ICRS/IC-Hack-Badge/Images/hacker-back-silkscreen.png

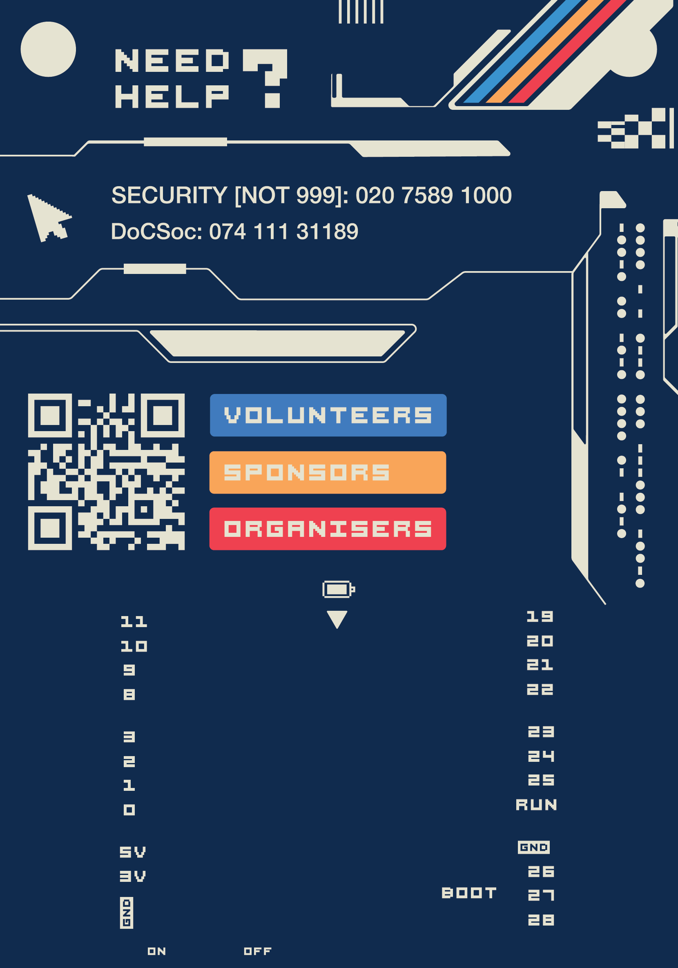
Images/hacker-back-silkscreen.png
