ICRS/IC-Hack-Badge/Images/hacker-back.png

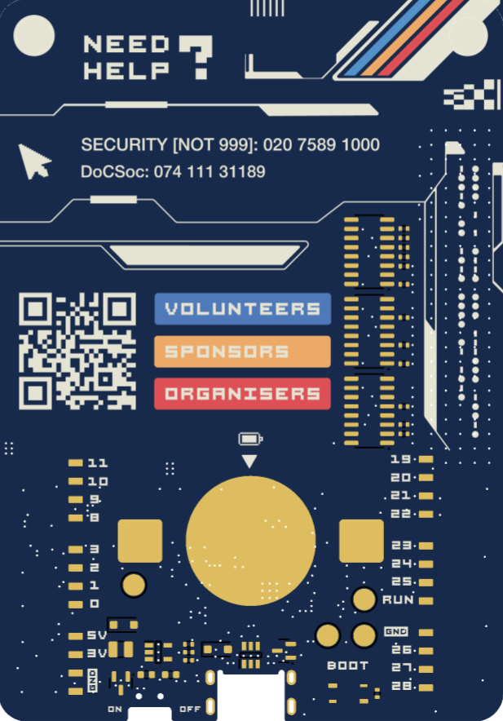
Images/hacker-back.png
