ICRS/IC-Hack-Badge/Images/hacker-front-silkscreen.png

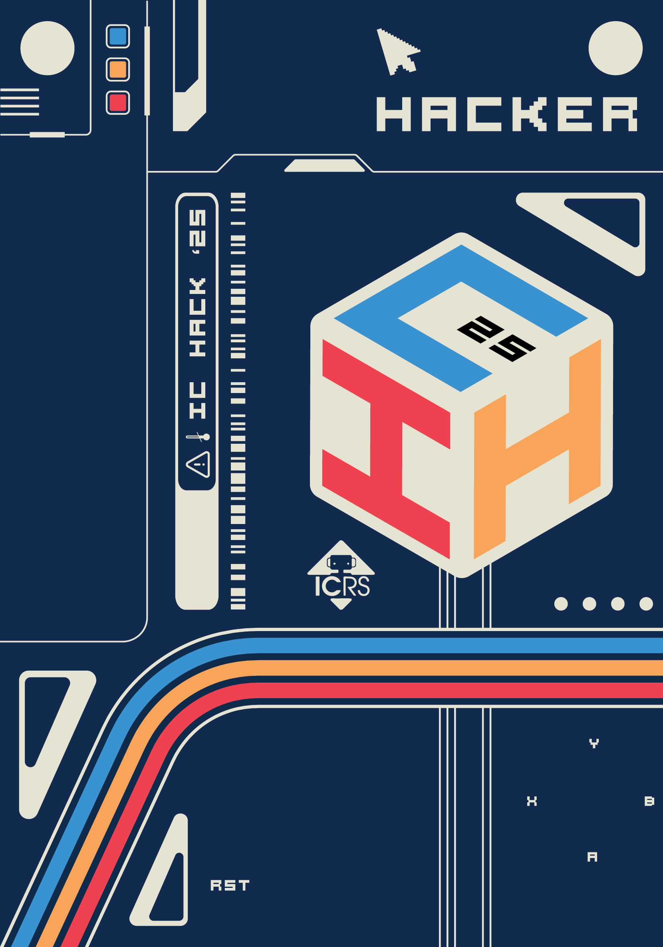
Images/hacker-front-silkscreen.png
