ICRS/IC-Hack-Badge/Images/pinout_whole.png

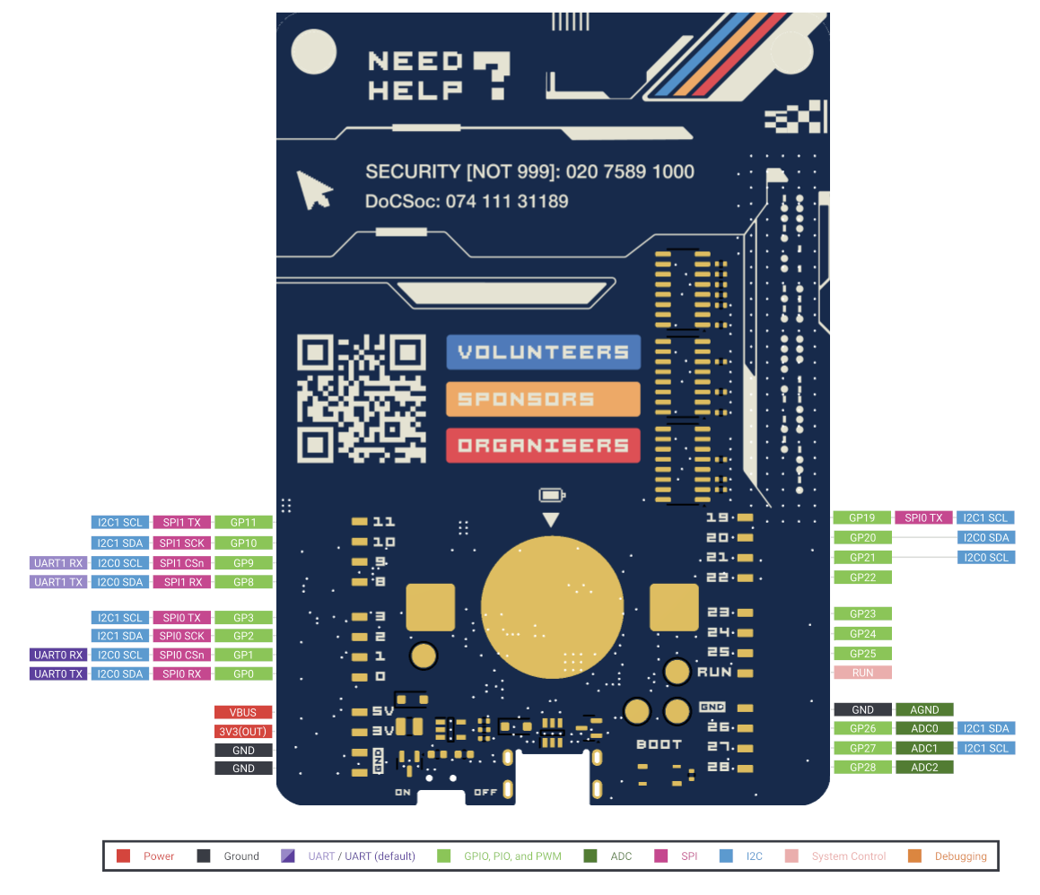
Images/pinout_whole.png
