ICRS/IC-Hack-Badge/Hardware/schematic.pdf

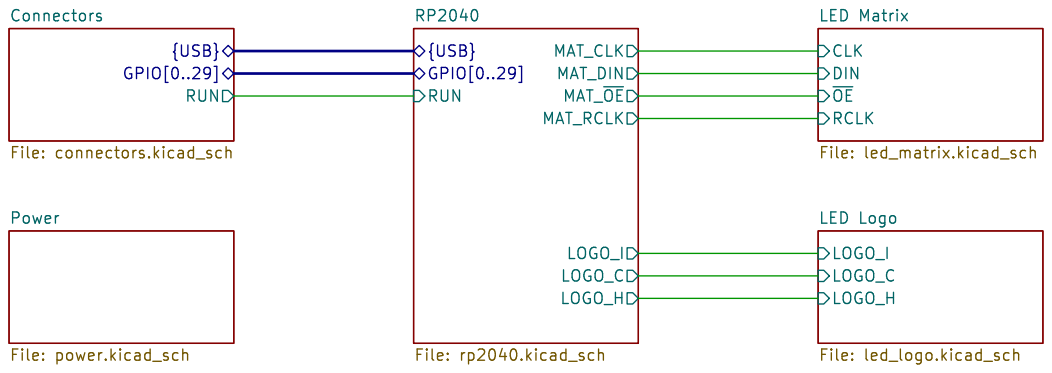
[picture p13: page 1]

{USB} RUN GPIO[0..29] Connectors File: connectors.kicad_sch

~{OE} LED Matrix File: led_matrix.kicad_sch

LED Logo File: led_logo.kicad_sch Power File: power.kicad_sch

Id: 1/6 Title: File: badge_v2.kicad_sch Sheet: /

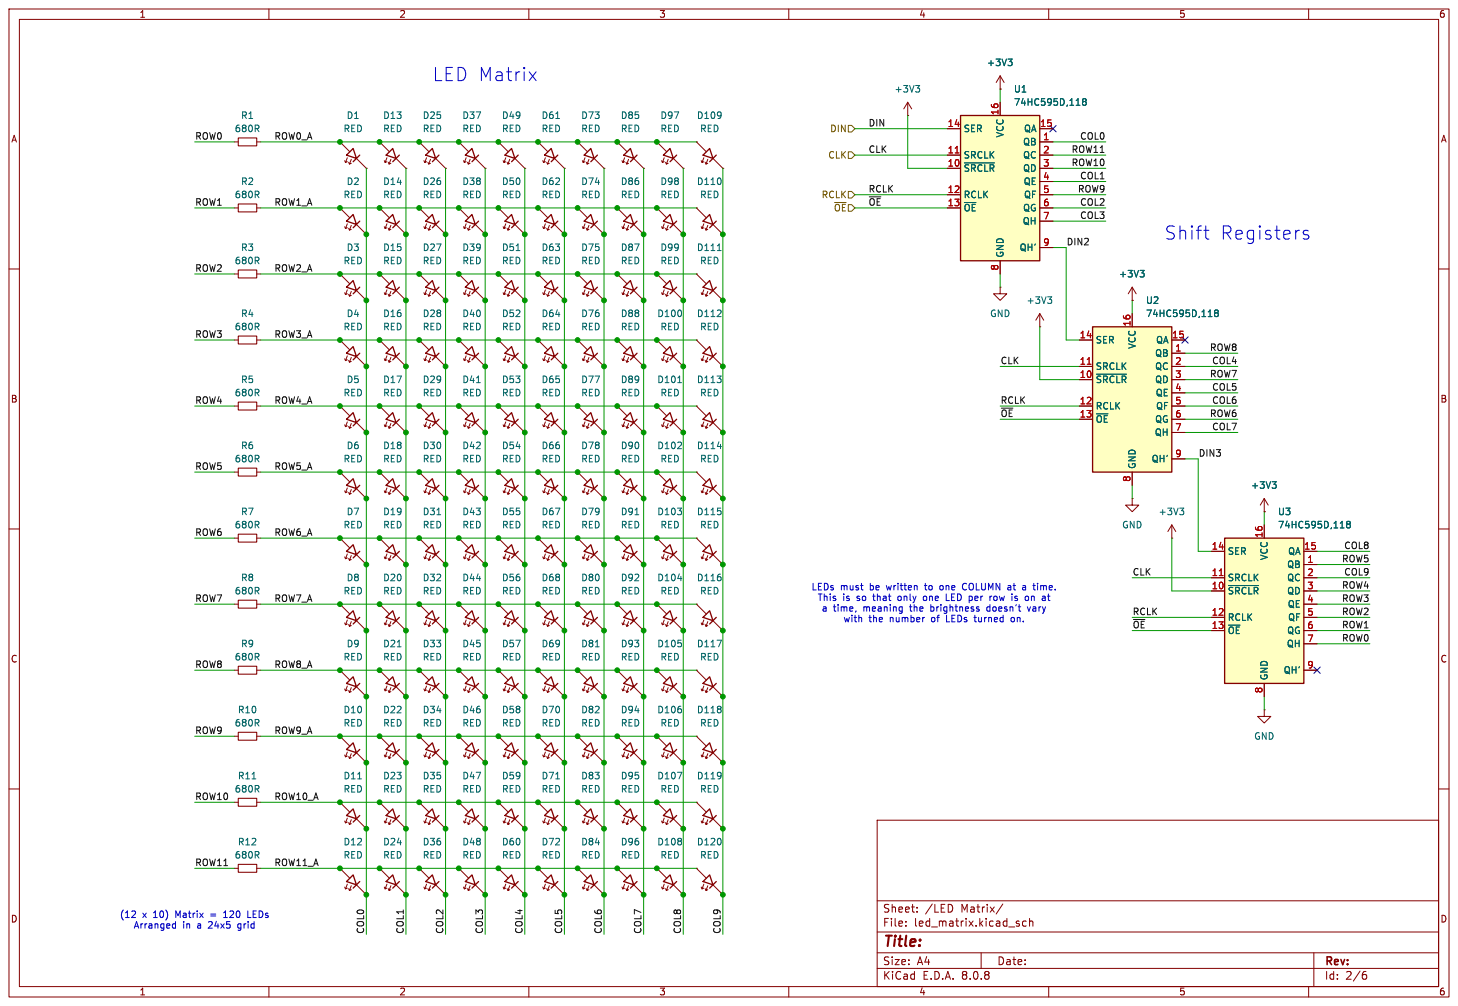
[picture p14: page 2]

(12 x 10) Matrix = 120 LEDs Arranged in a 24x5 grid

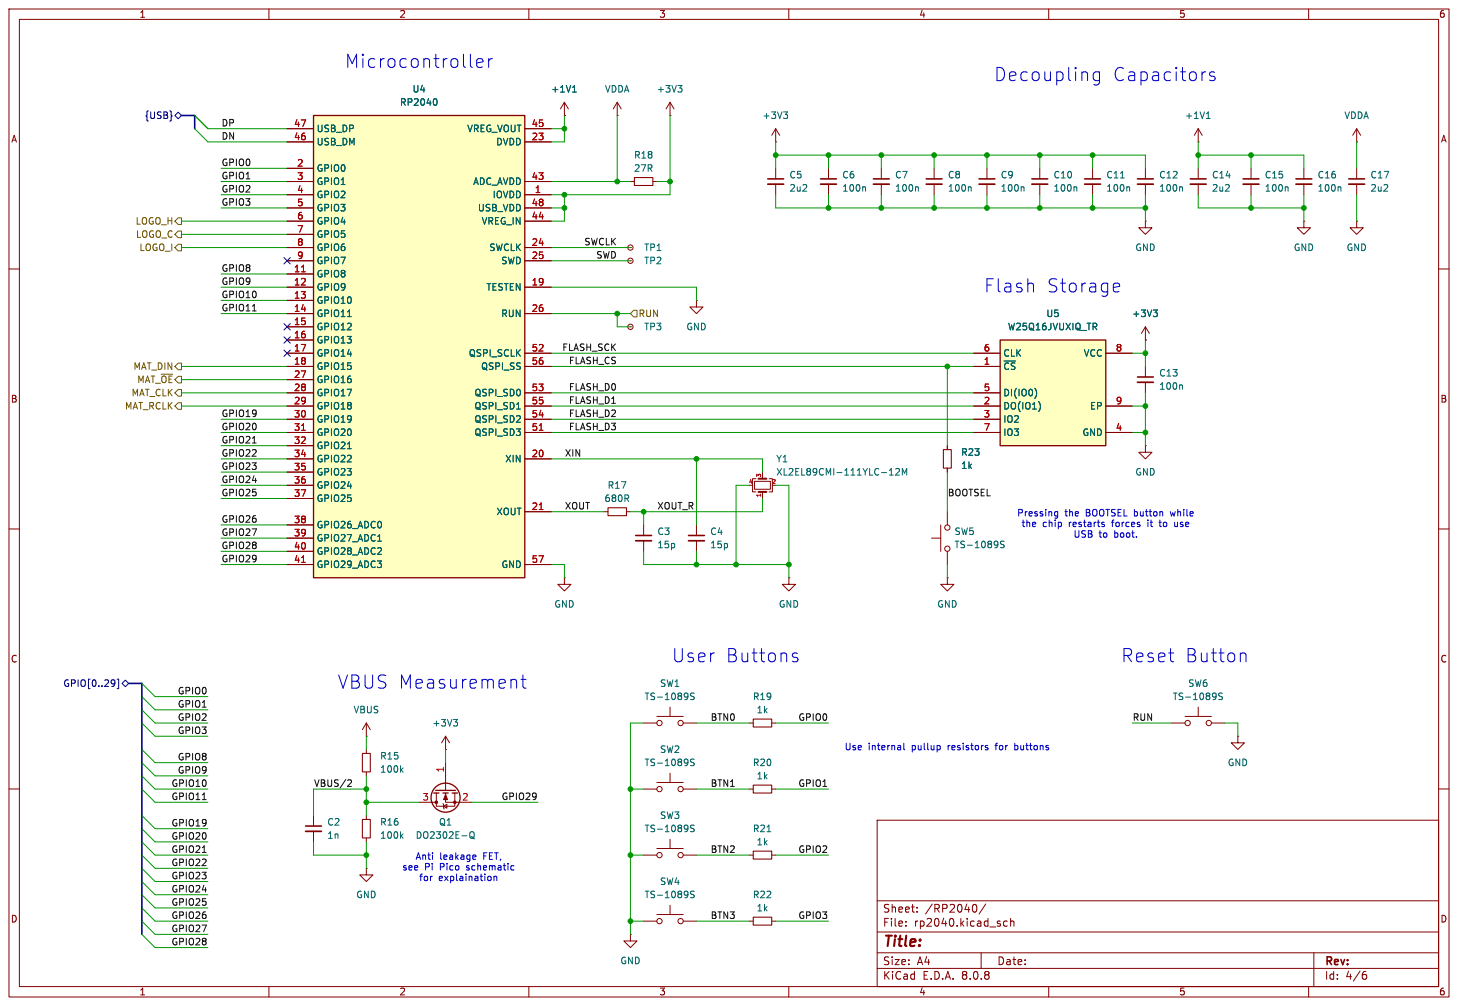
[picture p15: page 3]

Id: 4/6 Title: File: rp2040.kicad_sch Sheet: /RP2040/ R23

Pressing the BOOTSEL button while

Anti leakage FET, see Pi Pico schematic

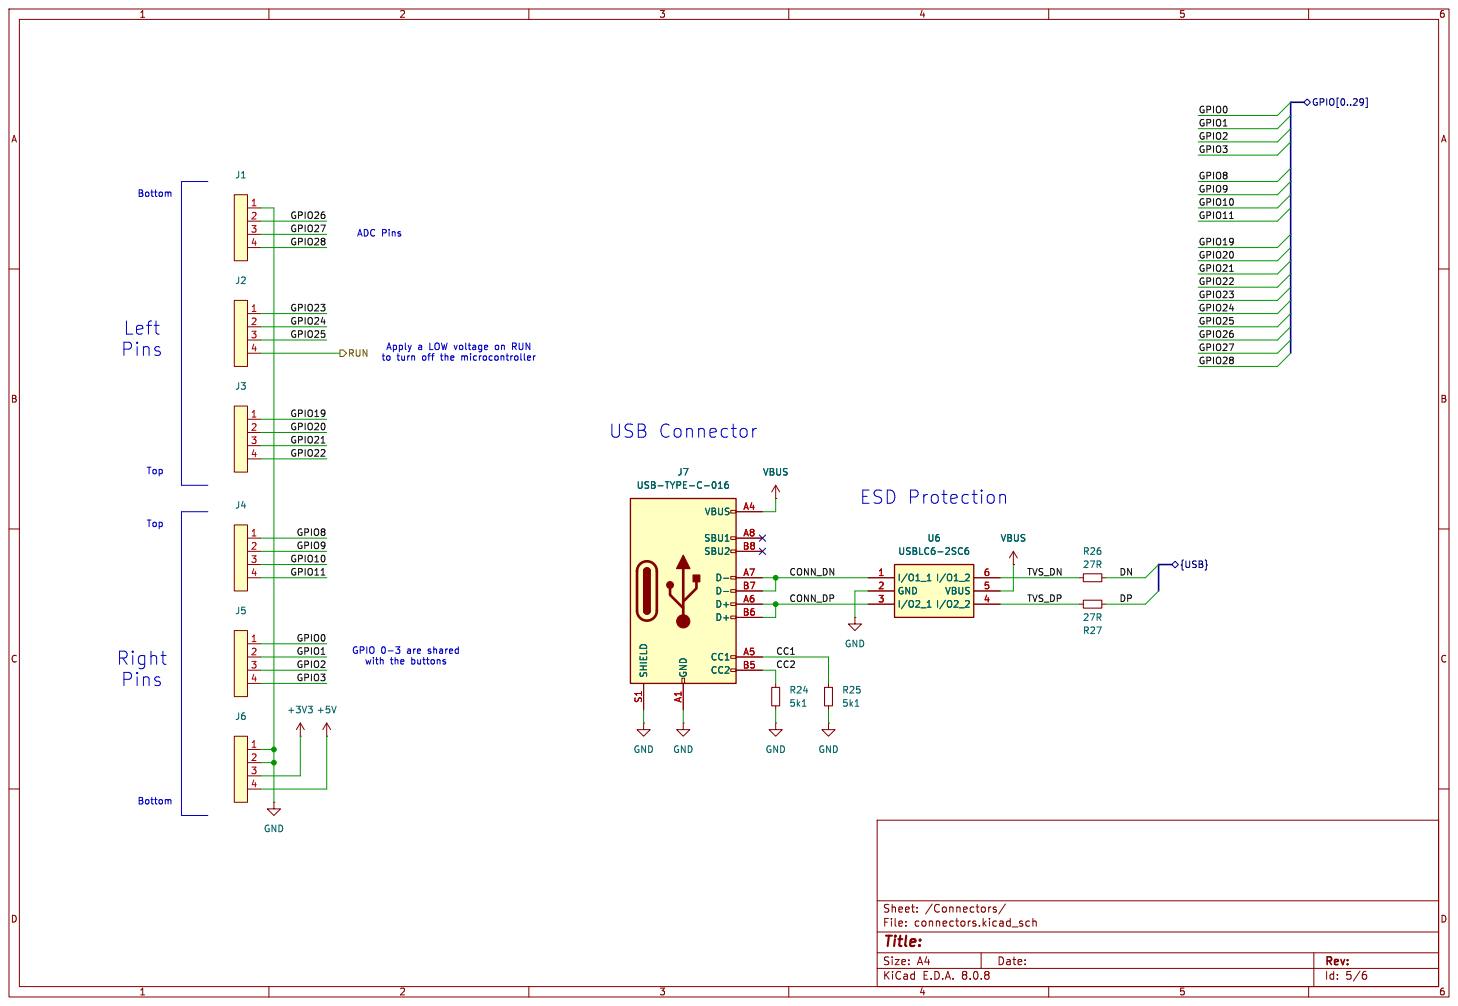
[picture p16: page 4]

Apply a LOW voltage on RUN

Id: 5/6 Title: File: connectors.kicad_sch Sheet: /Connectors/

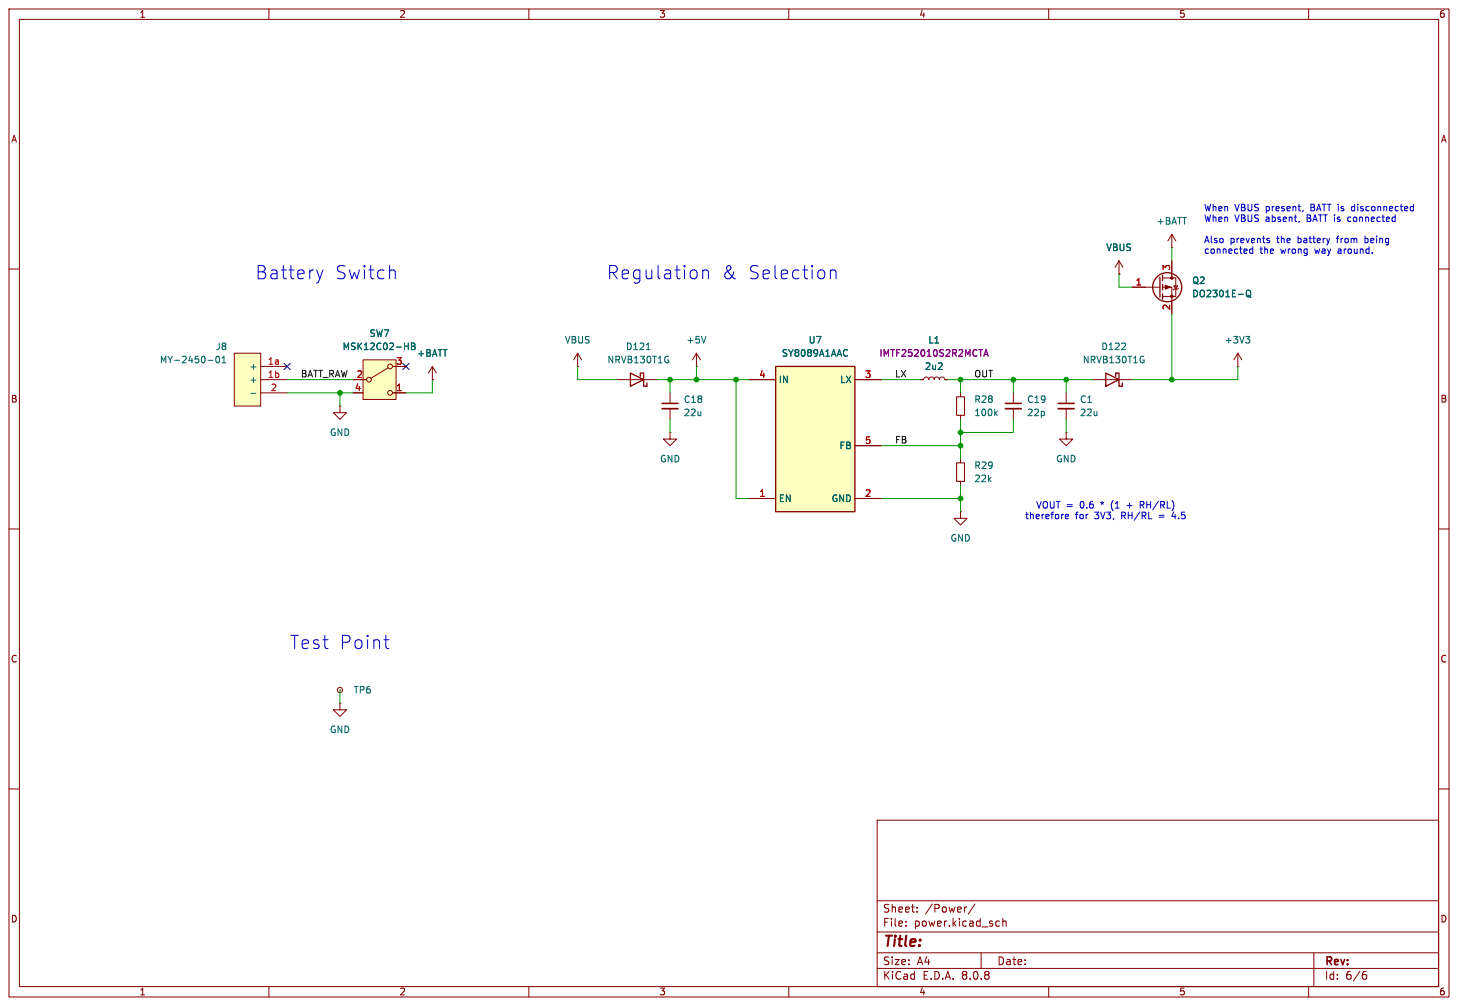
[picture p17: page 5]

Id: 6/6 Title: File: power.kicad_sch Sheet: /Power/

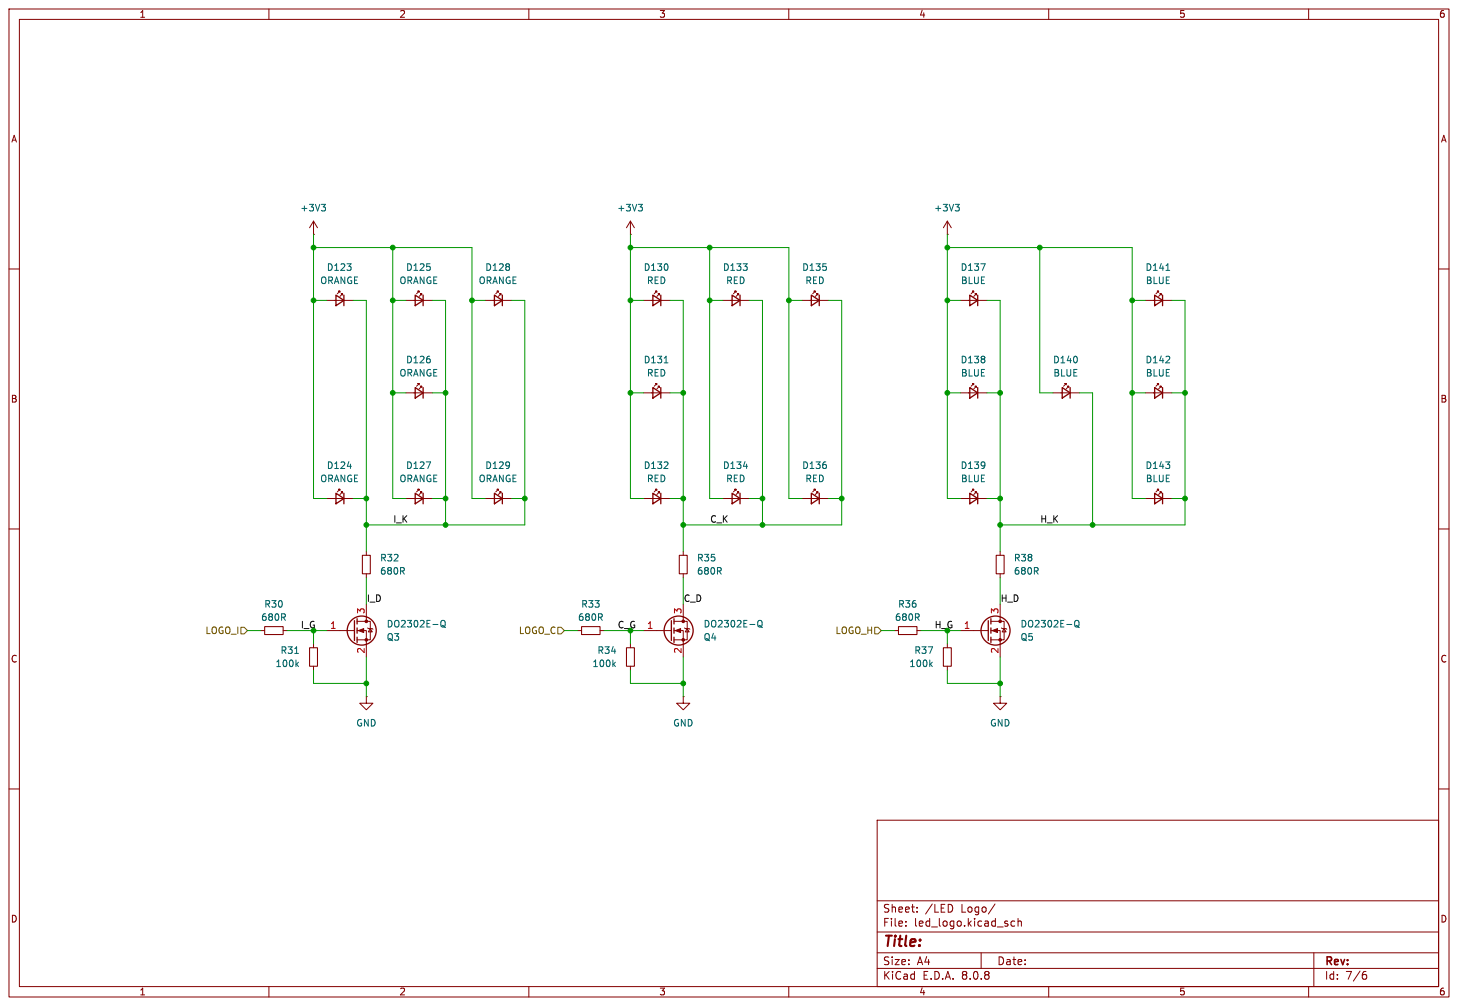
[picture p18: page 6]
