ICRS/IC-Hack-Badge/Hardware/badge_v2/badge_v2.kicad_pcb

## KiCad design Hardware/badge_v2/badge_v2.kicad_pcb (2025-01-31)

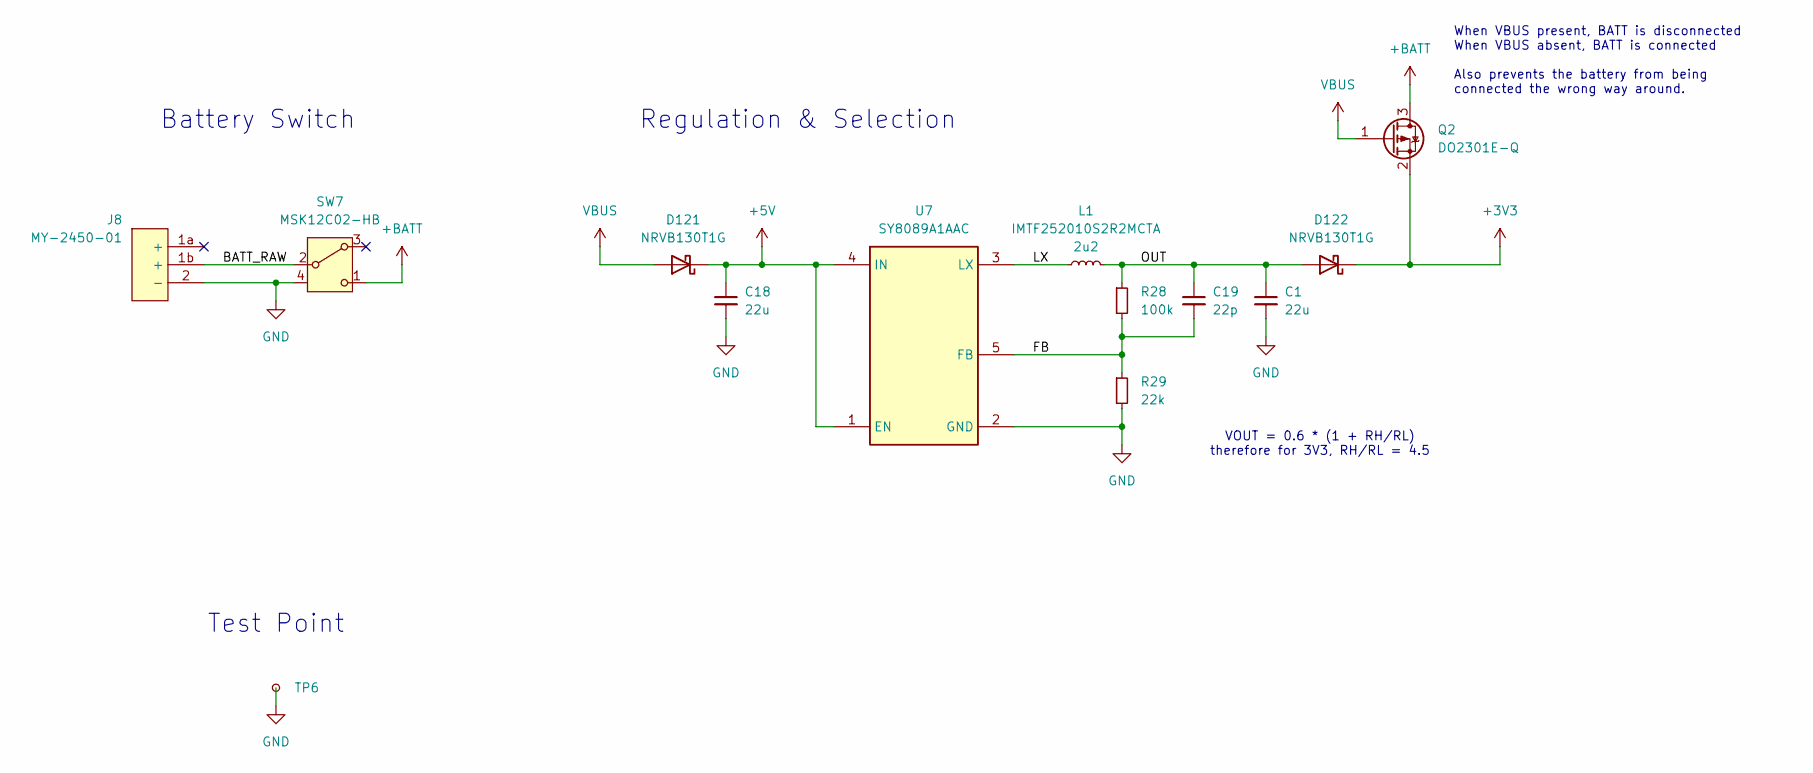
[picture p19: schematic power.kicad_sch]

Parts:
C1, C18: 22u; C_0603_1608Metric
C19: 22p; C_0402_1005Metric
D121, D122: NRVB130T1G; D_SOD-123F; LCSC part number C917121
J8: MY-2450-01; LCSC part number C964845
L1: 2u2; L_1008_2520Metric; Part IMTF252010S2R2MCTA; LCSC part number C19631588
Q2: DO2301E-Q; SOT-23; LCSC part number C41384537
R28: 100k; R_0402_1005Metric
R29: 22k; R_0402_1005Metric
SW7: MSK12C02-HB; LCSC part number C5149817
TP6: TestPoint_Small; TestPoint_Pad_D3.0mm
U7: SY8089A1AAC; SOT95P285X130-5N; Manufacturer_Part_Number SY8089A1AAC; LCSC part number C479074

Connections:
+3V3: D122.1 (K), Q2.2 (S); also elsewhere on the board
+5V: C18.1, D121.1 (K), U7.1 (EN), U7.4 (IN); also elsewhere on the board
+BATT: Q2.3 (D), SW7.1 (C)
/Power/BATT_RAW: J8.1b (+), SW7.2 (B)
/Power/FB: C19.2, R28.2, R29.1, U7.5 (FB)
/Power/LX: L1.1, U7.3 (LX)
/Power/OUT: C1.1, C19.1, D122.2 (A), L1.2, R28.1
GND: C1.2, C18.2, J8.2 (-), R29.2, SW7.4, TP6.1, U7.2 (GND); also elsewhere on the board
VBUS: D121.2 (A), Q2.1 (G); also elsewhere on the board

Notes on the sheet:
Battery Switch
Test Point
When VBUS present, BATT is disconnected When VBUS absent, BATT is connected Also prevents the battery from being connected the wrong way around.
Regulation & Selection
VOUT = 0.6 * (1 + RH/RL) therefore for 3V3, RH/RL = 4.5

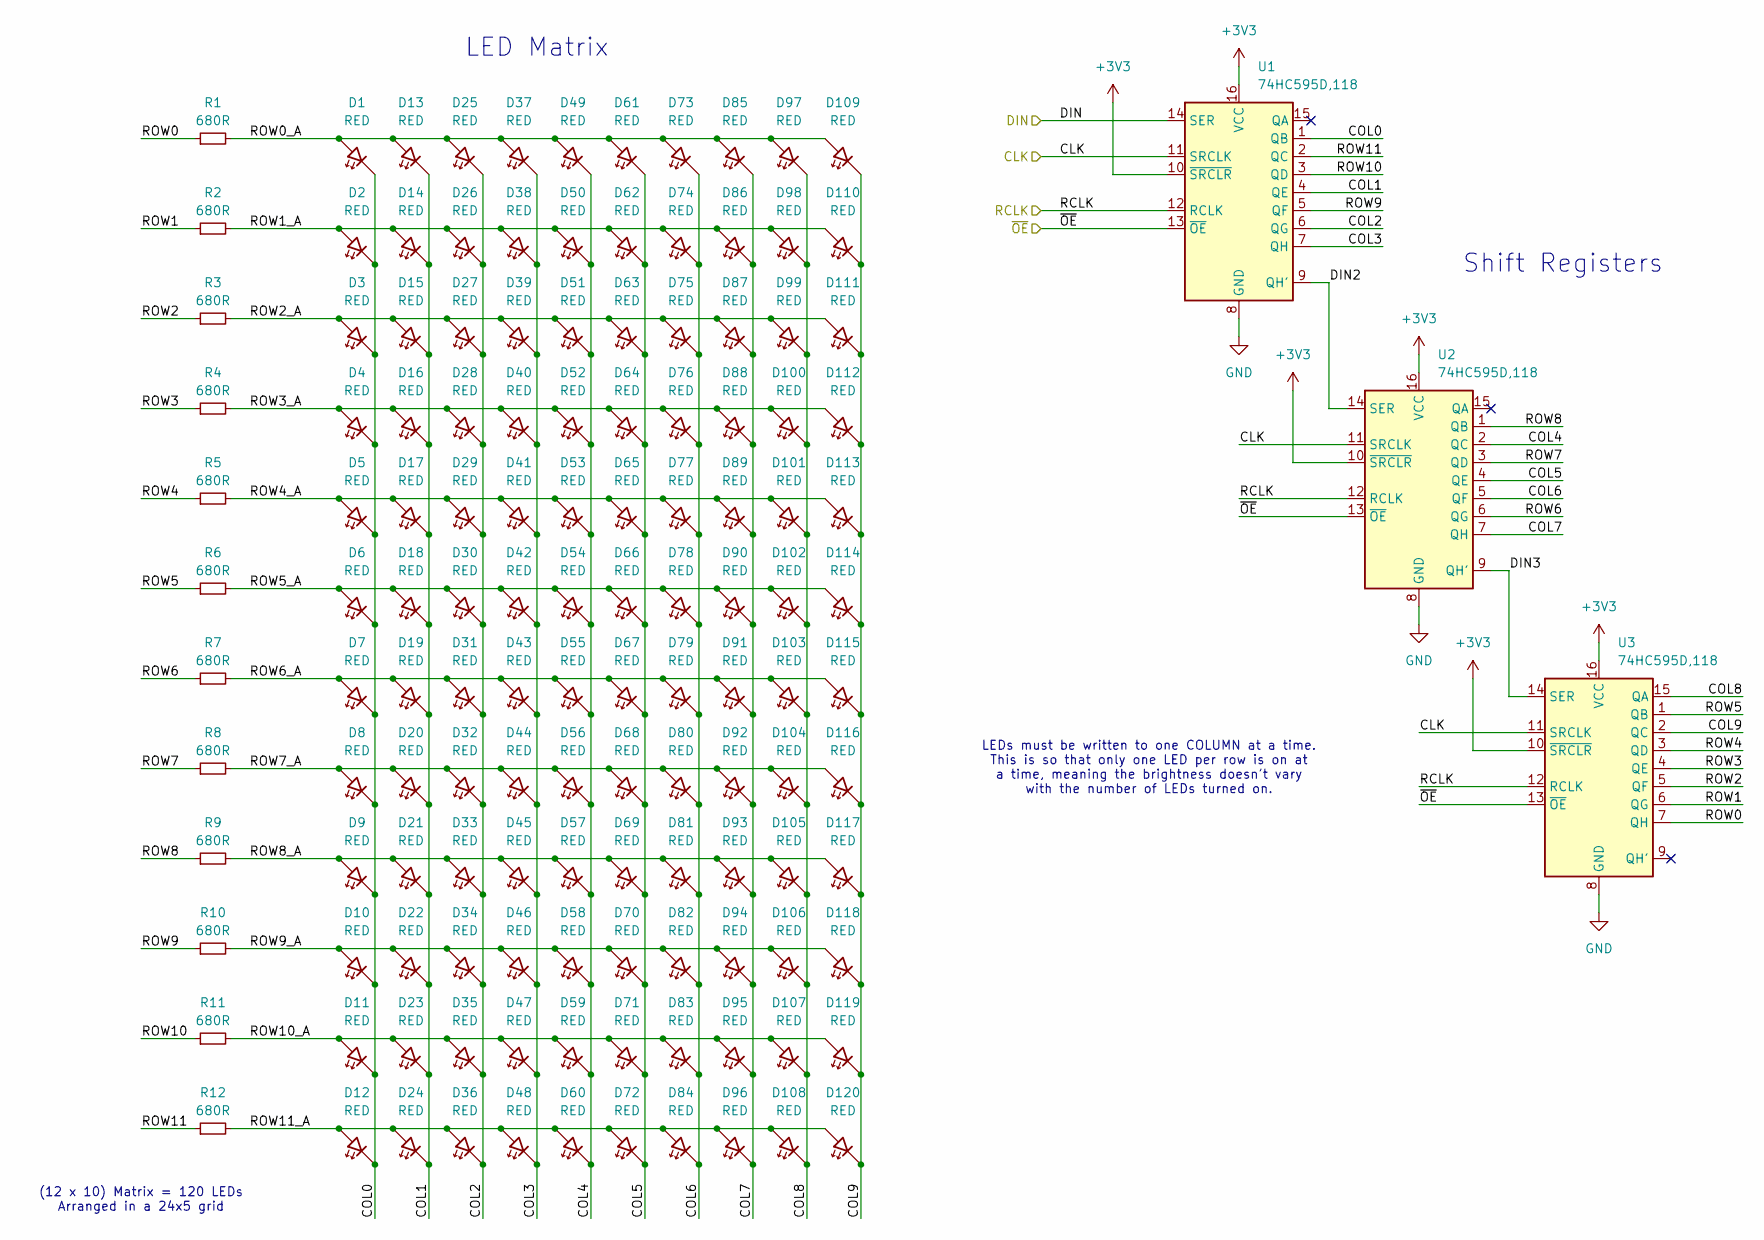
[picture p20: schematic led_matrix.kicad_sch]

Parts:
D1, D2, D3, D4, D5, D6, D7, D8, D9, D10, D11, D12, D13, D14, D15, D16, D17, D18, D19, D20, D21, D22, D23, D24, D25, D26, D27, D28, D29, D30, D31, D32, D33, D34, D35, D36, D37, D38, D39, D40, D41, D42, D43, D44, D45, D46, D47, D48, D49, D50, D51, D52, D53, D54, D55, D56, D57, D58, D59, D60, D61, D62, D63, D64, D65, D66, D67, D68, D69, D70, D71, D72, D73, D74, D75, D76, D77, D78, D79, D80, D81, D82, D83, D84, D85, D86, D87, D88, D89, D90, D91, D92, D93, D94, D95, D96, D97, D98, D99, D100, D101, D102, D103, D104, D105, D106, D107, D108, D109, D110, D111, D112, D113, D114, D115, D116, D117, D118, D119, D120: RED; LED_0402_1005Metric
R1, R2, R3, R4, R5, R6, R7, R8, R9, R10, R11, R12: 680R; R_0402_1005Metric
U1, U2, U3: 74HC595D,118; SOIC-16_3.9x9.9mm_P1.27mm; LCSC part number C5947

Connections:
+3V3: U1.10 (~SRCLR), U1.16 (VCC), U2.10 (~SRCLR), U2.16 (VCC), U3.10 (~SRCLR), U3.16 (VCC); also elsewhere on the board
/LED Matrix/CLK: U1.11 (SRCLK), U2.11 (SRCLK), U3.11 (SRCLK); also elsewhere on the board
/LED Matrix/COL0: D1.1 (K), D2.1 (K), D3.1 (K), D4.1 (K), D5.1 (K), D6.1 (K), D7.1 (K), D8.1 (K), D9.1 (K), D10.1 (K), D11.1 (K), D12.1 (K), U1.1 (QB)
/LED Matrix/COL1: D13.1 (K), D14.1 (K), D15.1 (K), D16.1 (K), D17.1 (K), D18.1 (K), D19.1 (K), D20.1 (K), D21.1 (K), D22.1 (K), D23.1 (K), D24.1 (K), U1.4 (QE)
/LED Matrix/COL2: D25.1 (K), D26.1 (K), D27.1 (K), D28.1 (K), D29.1 (K), D30.1 (K), D31.1 (K), D32.1 (K), D33.1 (K), D34.1 (K), D35.1 (K), D36.1 (K), U1.6 (QG)
/LED Matrix/COL3: D37.1 (K), D38.1 (K), D39.1 (K), D40.1 (K), D41.1 (K), D42.1 (K), D43.1 (K), D44.1 (K), D45.1 (K), D46.1 (K), D47.1 (K), D48.1 (K), U1.7 (QH)
/LED Matrix/COL4: D49.1 (K), D50.1 (K), D51.1 (K), D52.1 (K), D53.1 (K), D54.1 (K), D55.1 (K), D56.1 (K), D57.1 (K), D58.1 (K), D59.1 (K), D60.1 (K), U2.2 (QC)
/LED Matrix/COL5: D61.1 (K), D62.1 (K), D63.1 (K), D64.1 (K), D65.1 (K), D66.1 (K), D67.1 (K), D68.1 (K), D69.1 (K), D70.1 (K), D71.1 (K), D72.1 (K), U2.4 (QE)
/LED Matrix/COL6: D73.1 (K), D74.1 (K), D75.1 (K), D76.1 (K), D77.1 (K), D78.1 (K), D79.1 (K), D80.1 (K), D81.1 (K), D82.1 (K), D83.1 (K), D84.1 (K), U2.5 (QF)
/LED Matrix/COL7: D85.1 (K), D86.1 (K), D87.1 (K), D88.1 (K), D89.1 (K), D90.1 (K), D91.1 (K), D92.1 (K), D93.1 (K), D94.1 (K), D95.1 (K), D96.1 (K), U2.7 (QH)
/LED Matrix/COL8: D97.1 (K), D98.1 (K), D99.1 (K), D100.1 (K), D101.1 (K), D102.1 (K), D103.1 (K), D104.1 (K), D105.1 (K), D106.1 (K), D107.1 (K), D108.1 (K), U3.15 (QA)
/LED Matrix/COL9: D109.1 (K), D110.1 (K), D111.1 (K), D112.1 (K), D113.1 (K), D114.1 (K), D115.1 (K), D116.1 (K), D117.1 (K), D118.1 (K), D119.1 (K), D120.1 (K), U3.2 (QC)
/LED Matrix/DIN: U1.14 (SER); also elsewhere on the board
/LED Matrix/DIN2: U1.9 (QH'), U2.14 (SER)
/LED Matrix/DIN3: U2.9 (QH'), U3.14 (SER)
/LED Matrix/RCLK: U1.12 (RCLK), U2.12 (RCLK), U3.12 (RCLK); also elsewhere on the board
/LED Matrix/ROW0: R1.1, U3.7 (QH)
/LED Matrix/ROW0_A: D1.2 (A), D13.2 (A), D25.2 (A), D37.2 (A), D49.2 (A), D61.2 (A), D73.2 (A), D85.2 (A), D97.2 (A), D109.2 (A), R1.2
/LED Matrix/ROW1: R2.1, U3.6 (QG)
/LED Matrix/ROW1_A: D2.2 (A), D14.2 (A), D26.2 (A), D38.2 (A), D50.2 (A), D62.2 (A), D74.2 (A), D86.2 (A), D98.2 (A), D110.2 (A), R2.2
/LED Matrix/ROW2: R3.1, U3.5 (QF)
/LED Matrix/ROW2_A: D3.2 (A), D15.2 (A), D27.2 (A), D39.2 (A), D51.2 (A), D63.2 (A), D75.2 (A), D87.2 (A), D99.2 (A), D111.2 (A), R3.2
/LED Matrix/ROW3: R4.1, U3.4 (QE)
/LED Matrix/ROW3_A: D4.2 (A), D16.2 (A), D28.2 (A), D40.2 (A), D52.2 (A), D64.2 (A), D76.2 (A), D88.2 (A), D100.2 (A), D112.2 (A), R4.2
/LED Matrix/ROW4: R5.1, U3.3 (QD)
/LED Matrix/ROW4_A: D5.2 (A), D17.2 (A), D29.2 (A), D41.2 (A), D53.2 (A), D65.2 (A), D77.2 (A), D89.2 (A), D101.2 (A), D113.2 (A), R5.2
/LED Matrix/ROW5: R6.1, U3.1 (QB)
/LED Matrix/ROW5_A: D6.2 (A), D18.2 (A), D30.2 (A), D42.2 (A), D54.2 (A), D66.2 (A), D78.2 (A), D90.2 (A), D102.2 (A), D114.2 (A), R6.2
/LED Matrix/ROW6: R7.1, U2.6 (QG)
/LED Matrix/ROW6_A: D7.2 (A), D19.2 (A), D31.2 (A), D43.2 (A), D55.2 (A), D67.2 (A), D79.2 (A), D91.2 (A), D103.2 (A), D115.2 (A), R7.2
/LED Matrix/ROW7: R8.1, U2.3 (QD)
/LED Matrix/ROW7_A: D8.2 (A), D20.2 (A), D32.2 (A), D44.2 (A), D56.2 (A), D68.2 (A), D80.2 (A), D92.2 (A), D104.2 (A), D116.2 (A), R8.2
/LED Matrix/ROW8: R9.1, U2.1 (QB)
/LED Matrix/ROW8_A: D9.2 (A), D21.2 (A), D33.2 (A), D45.2 (A), D57.2 (A), D69.2 (A), D81.2 (A), D93.2 (A), D105.2 (A), D117.2 (A), R9.2
/LED Matrix/ROW9: R10.1, U1.5 (QF)
/LED Matrix/ROW9_A: D10.2 (A), D22.2 (A), D34.2 (A), D46.2 (A), D58.2 (A), D70.2 (A), D82.2 (A), D94.2 (A), D106.2 (A), D118.2 (A), R10.2
/LED Matrix/ROW10: R11.1, U1.3 (QD)
/LED Matrix/ROW10_A: D11.2 (A), D23.2 (A), D35.2 (A), D47.2 (A), D59.2 (A), D71.2 (A), D83.2 (A), D95.2 (A), D107.2 (A), D119.2 (A), R11.2
/LED Matrix/ROW11: R12.1, U1.2 (QC)
/LED Matrix/ROW11_A: D12.2 (A), D24.2 (A), D36.2 (A), D48.2 (A), D60.2 (A), D72.2 (A), D84.2 (A), D96.2 (A), D108.2 (A), D120.2 (A), R12.2
/LED Matrix/~OE: U1.13 (~OE), U2.13 (~OE), U3.13 (~OE); also elsewhere on the board
GND: U1.8 (GND), U2.8 (GND), U3.8 (GND); also elsewhere on the board

Notes on the sheet:
LEDs must be written to one COLUMN at a time. This is so that only one LED per row is on at a time, meaning the brightness doesn't vary with the number of LEDs turned on.
LED Matrix
Shift Registers
(12 x 10) Matrix = 120 LEDs Arranged in a 24x5 grid

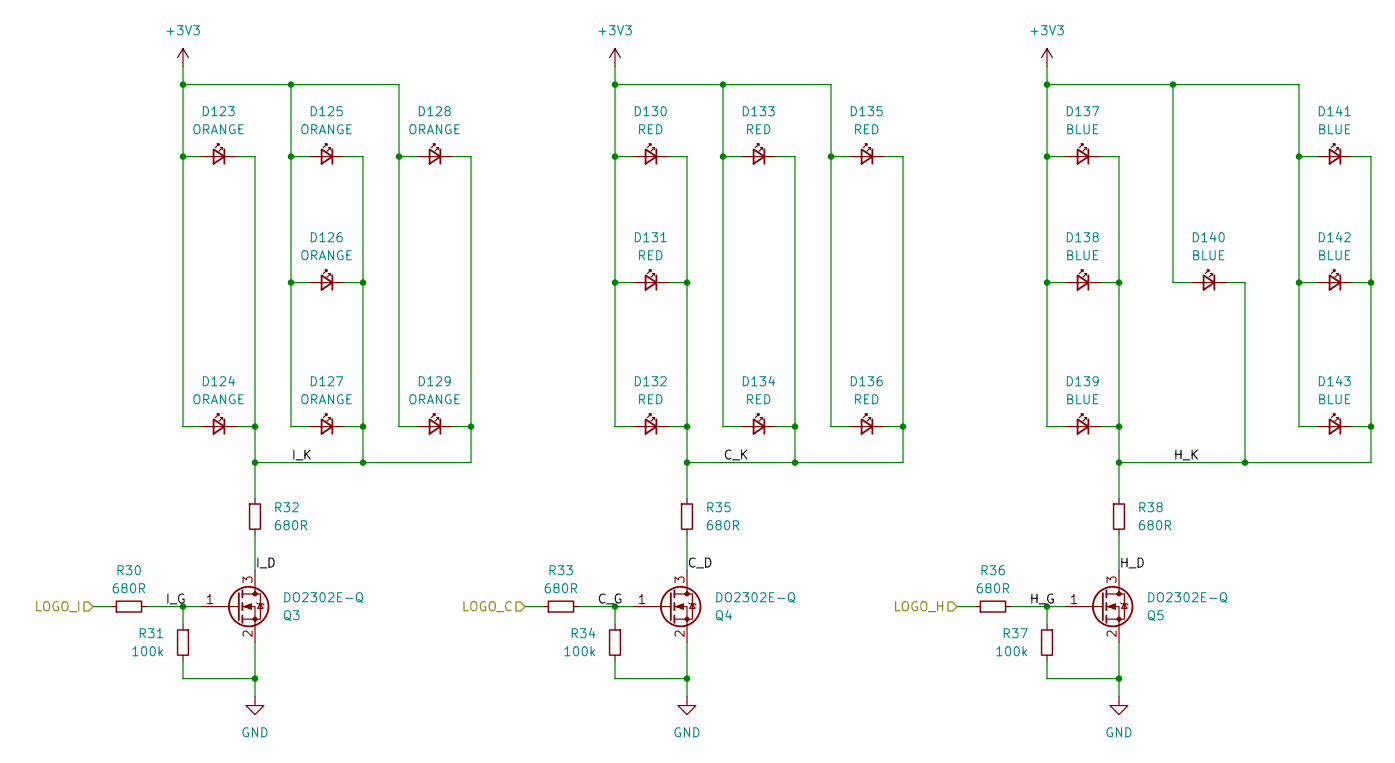
[picture p21: schematic led_logo.kicad_sch]

Parts:
D123, D124, D125, D126, D127, D128, D129: ORANGE; LED_0402_1005Metric
D130, D131, D132, D133, D134, D135, D136: RED; LED_0402_1005Metric
D137, D138, D139, D140, D141, D142, D143: BLUE; LED_0402_1005Metric
Q3, Q4, Q5: DO2302E-Q; SOT-23; LCSC part number C41384540
R30, R32, R33, R35, R36, R38: 680R; R_0402_1005Metric
R31, R34, R37: 100k; R_0402_1005Metric

Connections:
+3V3: D123.2 (A), D124.2 (A), D125.2 (A), D126.2 (A), D127.2 (A), D128.2 (A), D129.2 (A), D130.2 (A), D131.2 (A), D132.2 (A), D133.2 (A), D134.2 (A), D135.2 (A), D136.2 (A), D137.2 (A), D138.2 (A), D139.2 (A), D140.2 (A), D141.2 (A), D142.2 (A), D143.2 (A); also elsewhere on the board
/LED Logo/C_D: Q4.3 (D), R35.2
/LED Logo/C_G: Q4.1 (G), R33.2, R34.1
/LED Logo/C_K: D130.1 (K), D131.1 (K), D132.1 (K), D133.1 (K), D134.1 (K), D135.1 (K), D136.1 (K), R35.1
/LED Logo/H_D: Q5.3 (D), R38.2
/LED Logo/H_G: Q5.1 (G), R36.2, R37.1
/LED Logo/H_K: D137.1 (K), D138.1 (K), D139.1 (K), D140.1 (K), D141.1 (K), D142.1 (K), D143.1 (K), R38.1
/LED Logo/I_D: Q3.3 (D), R32.2
/LED Logo/I_G: Q3.1 (G), R30.2, R31.1
/LED Logo/I_K: D123.1 (K), D124.1 (K), D125.1 (K), D126.1 (K), D127.1 (K), D128.1 (K), D129.1 (K), R32.1
/LED Logo/LOGO_C: R33.1; also elsewhere on the board
/LED Logo/LOGO_H: R36.1; also elsewhere on the board
/LED Logo/LOGO_I: R30.1; also elsewhere on the board
GND: Q3.2 (S), Q4.2 (S), Q5.2 (S), R31.2, R34.2, R37.2; also elsewhere on the board

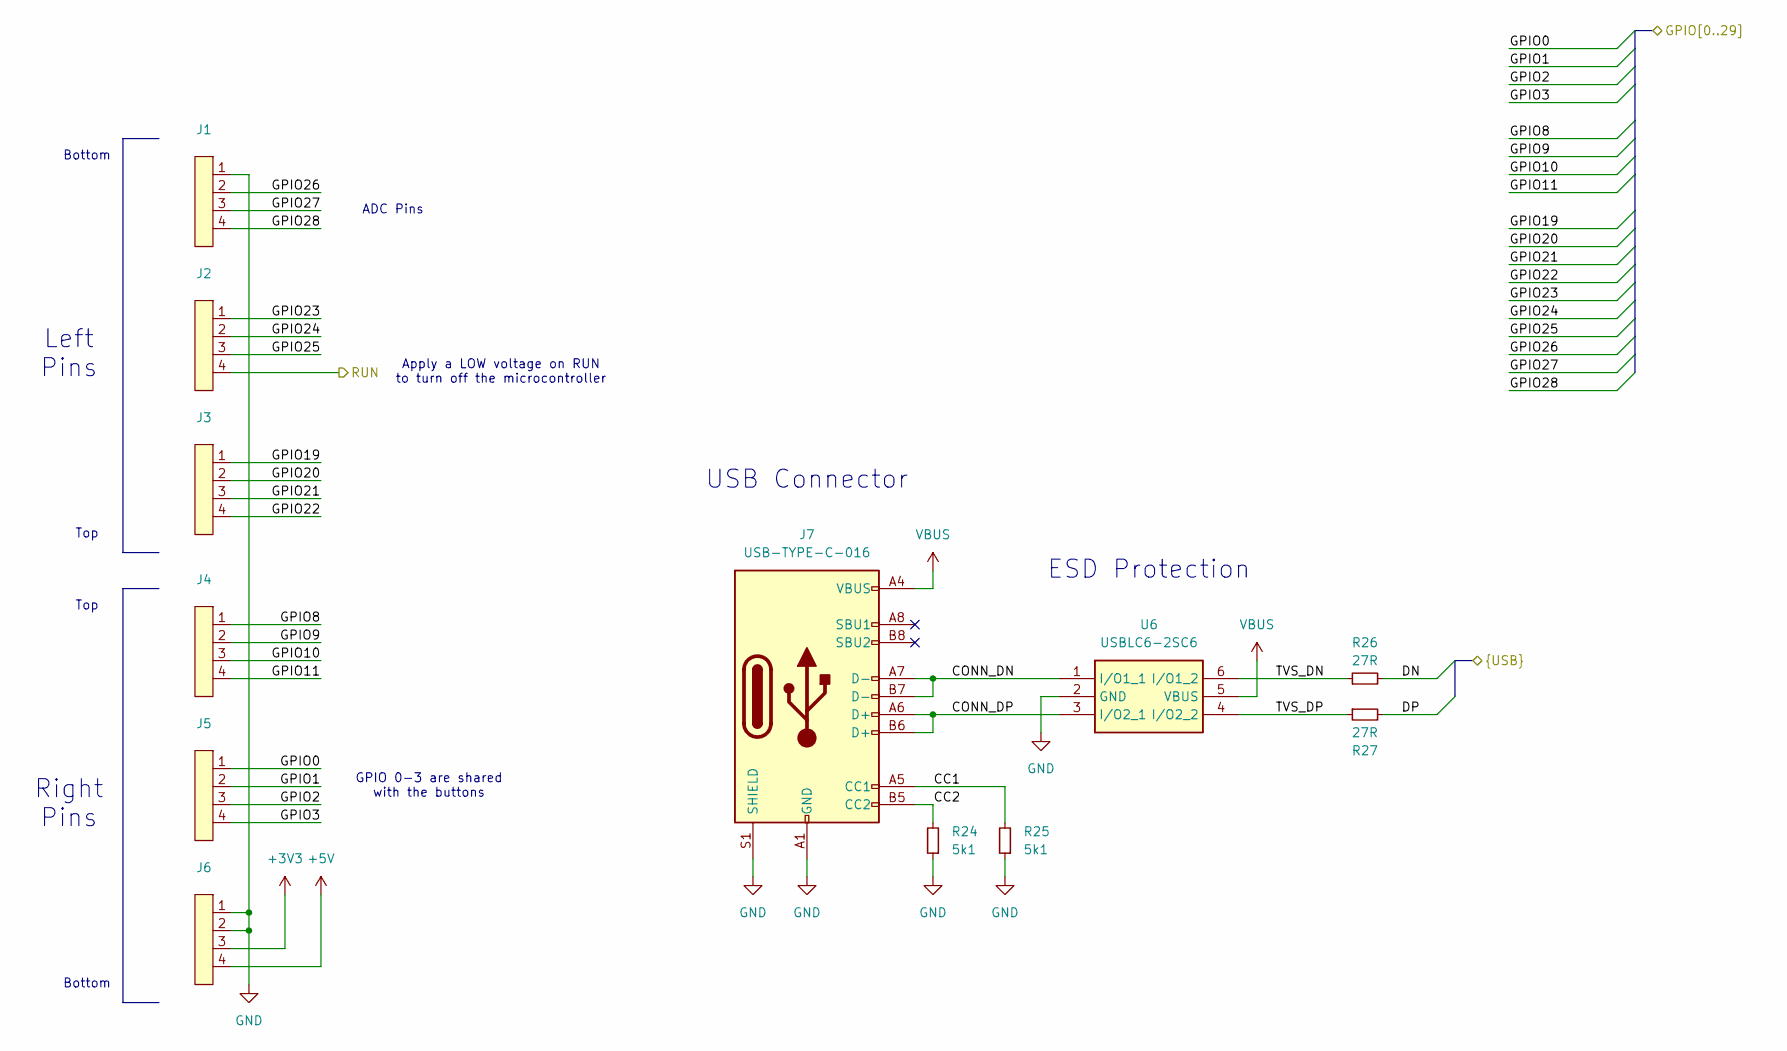
[picture p22: schematic connectors.kicad_sch]

Parts:
J1, J2, J3, J4, J5, J6: X6511FRS-04-C85D30; LCSC part number C5142237
J7: USB-TYPE-C-016; LCSC part number C2927036
R24, R25: 5k1; R_0402_1005Metric
R26, R27: 27R; R_0402_1005Metric
U6: USBLC6-2SC6; SOT95P280X145-6N; Manufacturer_Part_Number USBLC6-2SC6; Mouser Part Number 511-USBLC6-2SC6

Connections:
+3V3: J6.3; also elsewhere on the board
+5V: J6.4; also elsewhere on the board
/Connectors/CC1: J7.A5 (CC1), R25.2
/Connectors/CC2: J7.B5 (CC2), R24.2
/Connectors/CONN_DN: J7.A7 (D-), J7.B7 (D-), U6.1 (I/O1_1)
/Connectors/CONN_DP: J7.A6 (D+), J7.B6 (D+), U6.3 (I/O2_1)
/Connectors/DN: R26.2; also elsewhere on the board
/Connectors/DP: R27.2; also elsewhere on the board
/Connectors/GPIO0: J5.1; also elsewhere on the board
/Connectors/GPIO1: J5.2; also elsewhere on the board
/Connectors/GPIO2: J5.3; also elsewhere on the board
/Connectors/GPIO3: J5.4; also elsewhere on the board
/Connectors/GPIO8: J4.1; also elsewhere on the board
/Connectors/GPIO9: J4.2; also elsewhere on the board
/Connectors/GPIO10: J4.3; also elsewhere on the board
/Connectors/GPIO11: J4.4; also elsewhere on the board
/Connectors/GPIO19: J3.1; also elsewhere on the board
/Connectors/GPIO20: J3.2; also elsewhere on the board
/Connectors/GPIO21: J3.3; also elsewhere on the board
/Connectors/GPIO22: J3.4; also elsewhere on the board
/Connectors/GPIO23: J2.1; also elsewhere on the board
/Connectors/GPIO24: J2.2; also elsewhere on the board
/Connectors/GPIO25: J2.3; also elsewhere on the board
/Connectors/GPIO26: J1.2; also elsewhere on the board
/Connectors/GPIO27: J1.3; also elsewhere on the board
/Connectors/GPIO28: J1.4; also elsewhere on the board
/Connectors/TVS_DN: R26.1, U6.6 (I/O1_2)
/Connectors/TVS_DP: R27.1, U6.4 (I/O2_2)
/RP2040/RUN: J2.4; also elsewhere on the board
GND: J1.1, J6.1, J6.2, J7.A1 (GND), J7.A12 (GND), J7.B1 (GND), J7.B12 (GND), J7.S1 (SHIELD), R24.1, R25.1, U6.2 (GND); also elsewhere on the board
VBUS: J7.A4 (VBUS), J7.A9 (VBUS), J7.B4 (VBUS), J7.B9 (VBUS), U6.5 (VBUS); also elsewhere on the board

Notes on the sheet:
ESD Protection
ADC Pins
Top
GPIO 0-3 are shared with the buttons
Left Pins
Apply a LOW voltage on RUN to turn off the microcontroller
USB Connector
Bottom
Right Pins

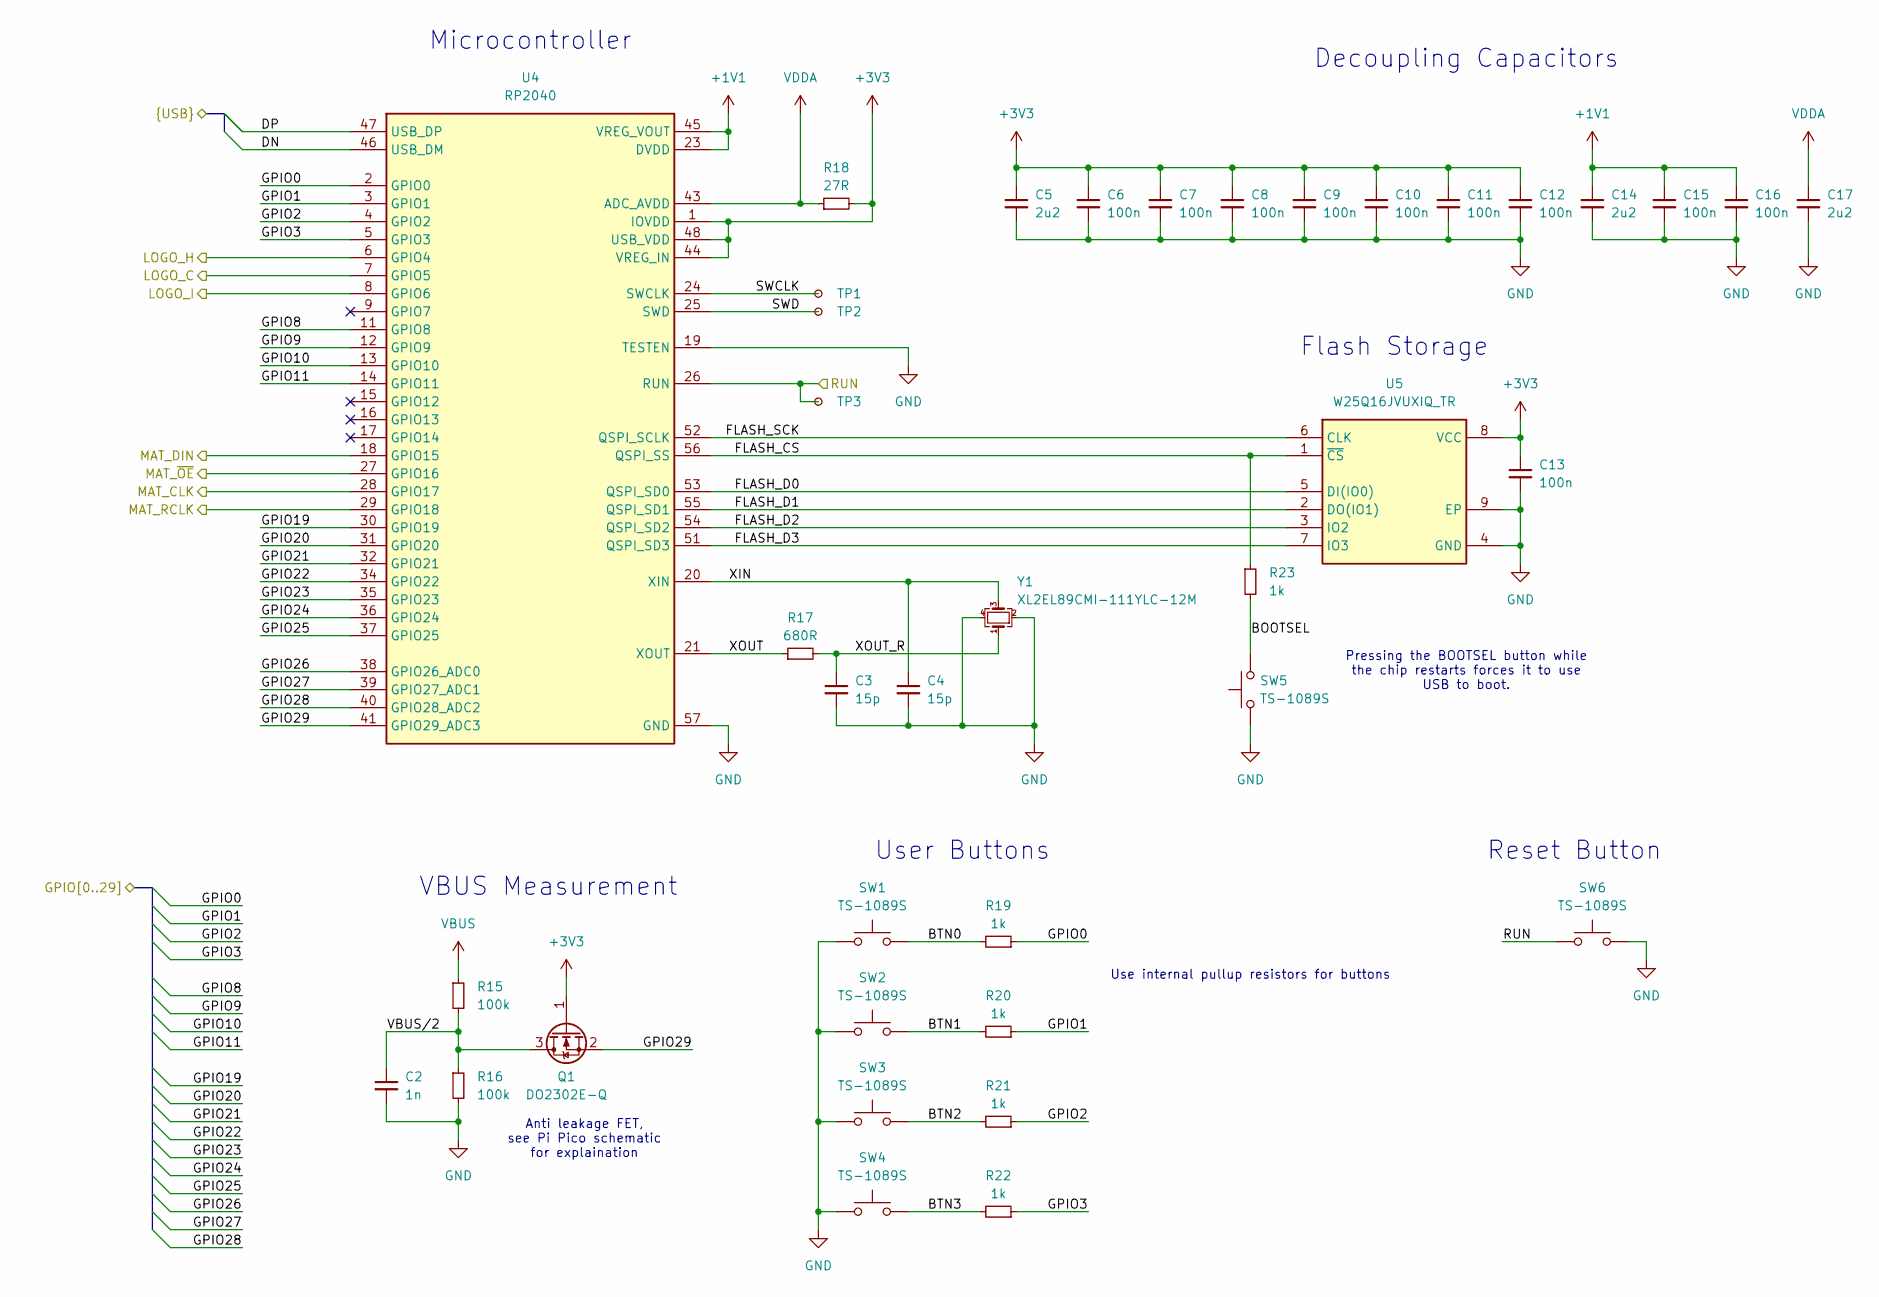
[picture p23: schematic rp2040.kicad_sch]

Parts:
C2: 1n; C_0402_1005Metric
C3, C4: 15p; C_0402_1005Metric
C5, C14, C17: 2u2; C_0402_1005Metric
C6, C7, C8, C9, C10, C11, C12, C13, C15, C16: 100n; C_0402_1005Metric
Q1: DO2302E-Q; SOT-23; LCSC part number C41384540
R15, R16: 100k; R_0402_1005Metric
R17: 680R; R_0402_1005Metric
R18: 27R; R_0402_1005Metric
R19, R20, R21, R22, R23: 1k; R_0402_1005Metric
SW1, SW2, SW3, SW4, SW5, SW6: TS-1089S; LCSC part number C455282
TP1, TP2, TP3: TestPoint_Small; TestPoint_Pad_D3.0mm
U4: RP2040; QFN-56-1EP_7x7mm_P0.4mm_EP3.2x3.2mm; LCSC part number C2040
U5: W25Q16JVUXIQ_TR; SON50P300X200X60-9N; Manufacturer_Part_Number W25Q16JVUXIQ TR; Mouser Part Number 454-W25Q16JVUXIQTR
Y1: XL2EL89CMI-111YLC-12M; Crystal_SMD_3225-4Pin_3.2x2.5mm; LCSC part number C7500570

Connections:
+1V1: C14.1, C15.1, C16.1, U4.23 (DVDD), U4.45 (VREG_VOUT), U4.50 (DVDD)
+3V3: C5.1, C6.1, C7.1, C8.1, C9.1, C10.1, C11.1, C12.1, C13.1, Q1.1 (G), R18.2, U4.1 (IOVDD), U4.10 (IOVDD), U4.22 (IOVDD), U4.33 (IOVDD), U4.42 (IOVDD), U4.44 (VREG_IN), U4.48 (USB_VDD), U4.49 (IOVDD), U5.8 (VCC); also elsewhere on the board
/Connectors/DN: U4.46 (USB_DM); also elsewhere on the board
/Connectors/DP: U4.47 (USB_DP); also elsewhere on the board
/Connectors/GPIO0: R19.1, U4.2 (GPIO0); also elsewhere on the board
/Connectors/GPIO1: R20.1, U4.3 (GPIO1); also elsewhere on the board
/Connectors/GPIO2: R21.1, U4.4 (GPIO2); also elsewhere on the board
/Connectors/GPIO3: R22.1, U4.5 (GPIO3); also elsewhere on the board
/Connectors/GPIO8: U4.11 (GPIO8); also elsewhere on the board
/Connectors/GPIO9: U4.12 (GPIO9); also elsewhere on the board
/Connectors/GPIO10: U4.13 (GPIO10); also elsewhere on the board
/Connectors/GPIO11: U4.14 (GPIO11); also elsewhere on the board
/Connectors/GPIO19: U4.30 (GPIO19); also elsewhere on the board
/Connectors/GPIO20: U4.31 (GPIO20); also elsewhere on the board
/Connectors/GPIO21: U4.32 (GPIO21); also elsewhere on the board
/Connectors/GPIO22: U4.34 (GPIO22); also elsewhere on the board
/Connectors/GPIO23: U4.35 (GPIO23); also elsewhere on the board
/Connectors/GPIO24: U4.36 (GPIO24); also elsewhere on the board
/Connectors/GPIO25: U4.37 (GPIO25); also elsewhere on the board
/Connectors/GPIO26: U4.38 (GPIO26_ADC0); also elsewhere on the board
/Connectors/GPIO27: U4.39 (GPIO27_ADC1); also elsewhere on the board
/Connectors/GPIO28: U4.40 (GPIO28_ADC2); also elsewhere on the board
/Connectors/GPIO29: Q1.2 (S), U4.41 (GPIO29_ADC3)
/LED Logo/LOGO_C: U4.7 (GPIO5); also elsewhere on the board
/LED Logo/LOGO_H: U4.6 (GPIO4); also elsewhere on the board
/LED Logo/LOGO_I: U4.8 (GPIO6); also elsewhere on the board
/LED Matrix/CLK: U4.28 (GPIO17); also elsewhere on the board
/LED Matrix/DIN: U4.18 (GPIO15); also elsewhere on the board
/LED Matrix/RCLK: U4.29 (GPIO18); also elsewhere on the board
/LED Matrix/~OE: U4.27 (GPIO16); also elsewhere on the board
/RP2040/BOOTSEL: R23.2, SW5.2
/RP2040/BTN0: R19.2, SW1.1
/RP2040/BTN1: R20.2, SW2.1
/RP2040/BTN2: R21.2, SW3.1
/RP2040/BTN3: R22.2, SW4.1
/RP2040/FLASH_CS: R23.1, U4.56 (QSPI_SS), U5.1 (~CS)
/RP2040/FLASH_D0: U4.53 (QSPI_SD0), U5.5 (DI(IO0))
/RP2040/FLASH_D1: U4.55 (QSPI_SD1), U5.2 (DO(IO1))
/RP2040/FLASH_D2: U4.54 (QSPI_SD2), U5.3 (IO2)
/RP2040/FLASH_D3: U4.51 (QSPI_SD3), U5.7 (IO3)
/RP2040/FLASH_SCK: U4.52 (QSPI_SCLK), U5.6 (CLK)
/RP2040/RUN: SW6.1, TP3.1, U4.26 (RUN); also elsewhere on the board
/RP2040/SWCLK: TP1.1, U4.24 (SWCLK)
/RP2040/SWD: TP2.1, U4.25 (SWD)
/RP2040/VBUS/2: C2.1, Q1.3 (D), R15.2, R16.1
/RP2040/XIN: C4.1, U4.20 (XIN), Y1.3
/RP2040/XOUT: R17.1, U4.21 (XOUT)
/RP2040/XOUT_R: C3.1, R17.2, Y1.1
GND: C2.2, C3.2, C4.2, C5.2, C6.2, C7.2, C8.2, C9.2, C10.2, C11.2, C12.2, C13.2, C14.2, C15.2, C16.2, C17.2, R16.2, SW1.2, SW2.2, SW3.2, SW4.2, SW5.1, SW6.2, U4.19 (TESTEN), U4.57 (GND), U5.4 (GND), U5.9 (EP), Y1.2, Y1.4; also elsewhere on the board
VBUS: R15.1; also elsewhere on the board
VDDA: C17.1, R18.1, U4.43 (ADC_AVDD)

Notes on the sheet:
Decoupling Capacitors
Use internal pullup resistors for buttons
Flash Storage
Microcontroller
User Buttons
VBUS Measurement
Reset Button
Anti leakage FET, see Pi Pico schematic for explaination
Pressing the BOOTSEL button while the chip restarts forces it to use USB to boot.

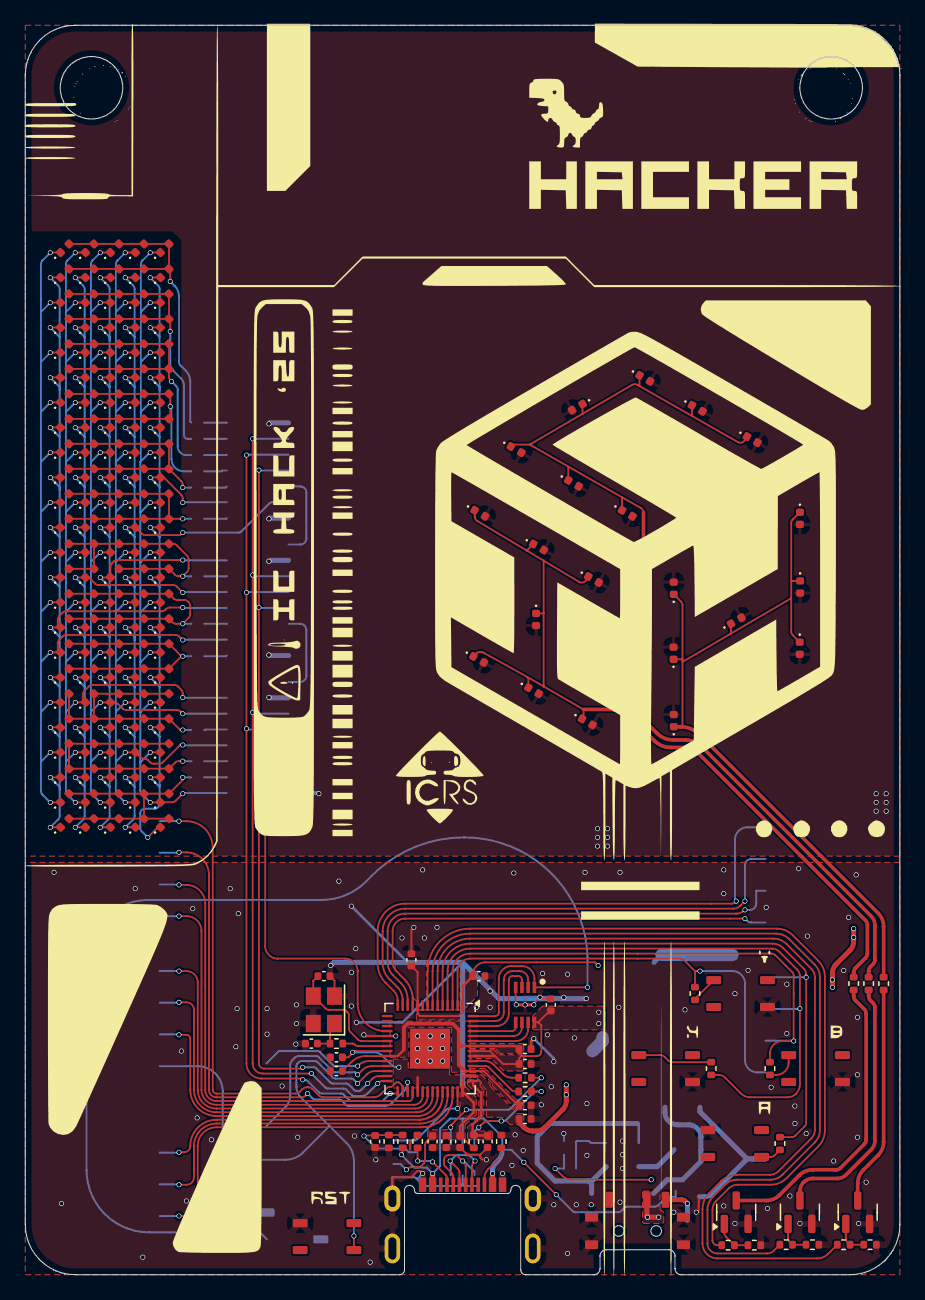
[picture p24: board badge_v2.kicad_pcb from above]

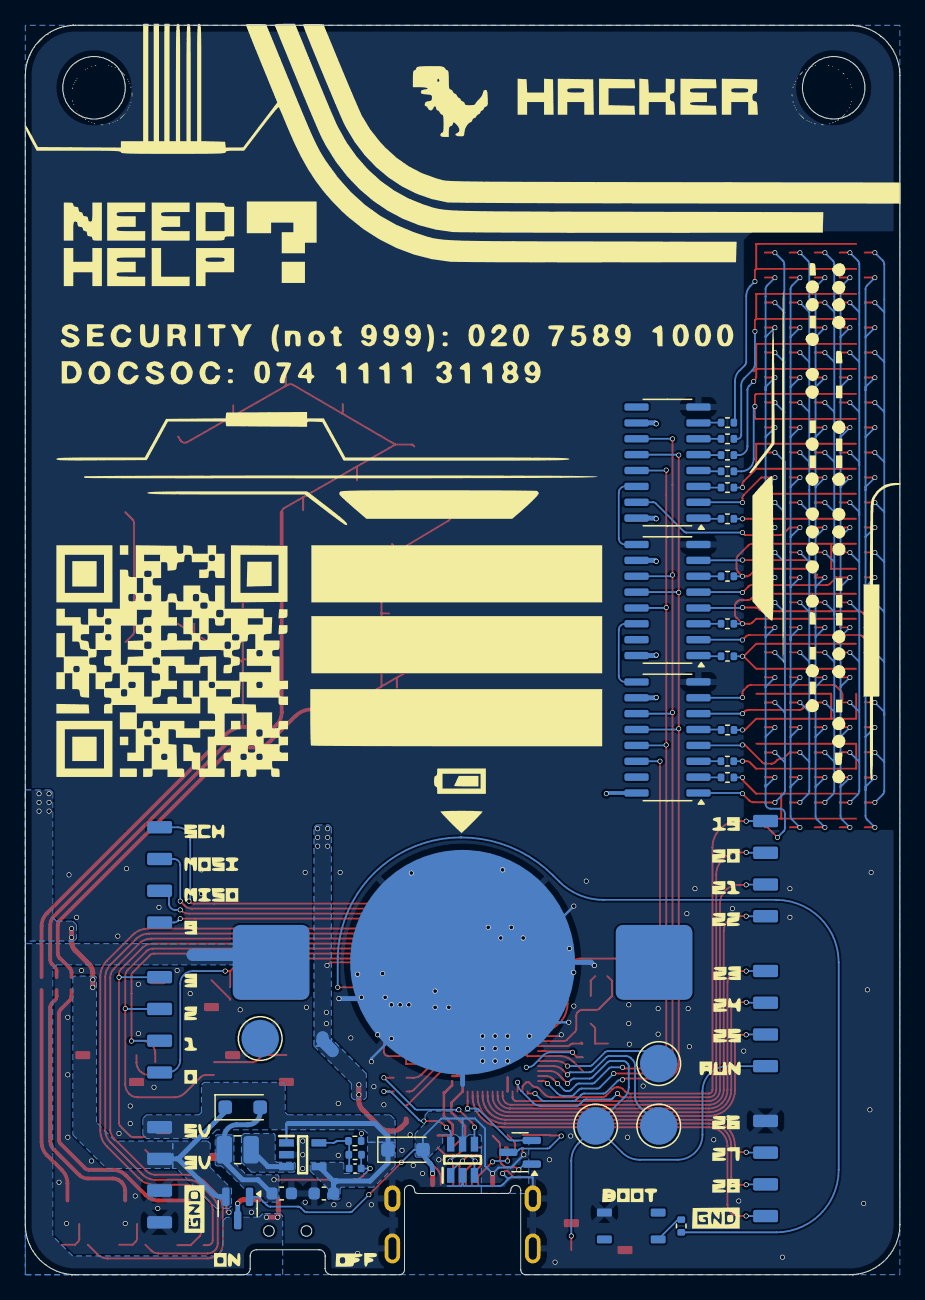
[picture p25: board badge_v2.kicad_pcb from below]

Board: 2 copper layers, 70.0 x 100.0 mm, 231 parts (40 on the bottom side), 108 nets.
