ICRS/IC-Hack-Badge/(commit log)

2025-01-31 Added arduino submodule
2025-01-31 Added hardware files and firmware binary
    [badge_v2.kicad_pcb, badge_v2.kicad_sch, connectors.kicad_sch, led_logo.kicad_sch, led_matrix.kicad_sch, power.kicad_sch, rp2040.kicad_sch]
2025-02-01 Added buttons to pin table
